Stan-Reifel/Nightlight-DFM-ENGR3260/README.md

# Nightlight-DFM-ENGR3260

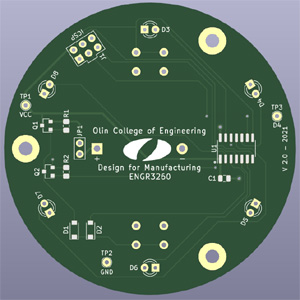
[picture p1: NightLightPCB-Top-ATTiny-300.jpg]
NightLightPCB-Top-ATTiny-300
