Stan-Reifel/Nightlight-DFM-ENGR3260/2021/Hardware/NightLight-BOM- Digikey.xls

Ref | Qnty | Value | Cmp name | Vendor
BT1, | 1 | CR2032_Holder | Battery_Cell | BS-7-ND or 36-1066-ND
D3, D4, D5, D6, D7, D8, | 6 | White LED | LED | 1516-QBL7IW60D-WW-ND
J1, | 1 | ISP Connector | ISP_Connector | S2012EC-03-ND
SW1, | 1 | POWER | SW_Push | EG1833-ND
SW2, | 1 | MODE | SW_Push | EG1833-ND
