Stan-Reifel/Nightlight-DFM-ENGR3260/2021/Hardware/Gerbers/NightLight-BOM.csv

Designator | Quantity | Value | Footprint | LCSC Part #
C1, | 1 | 100nf | 0805 | C49678
D1, D2, | 2 | 1N4148 | SOD-123 | C81598
Q1, | 1 | IRLML2244 | SOT-23 | C169763
Q2, | 1 | IRLML6344 | SOT-23 | C53550
R1, R2, | 2 | 680K | 0805 | C17797
U1, | 1 | ATtiny44A-SSU | SOIC-14 | C412819
