Stan-Reifel/Nightlight-DFM-ENGR3260/2020/LEDAlignmentJig/LEDAlignmentJig.SLDPRT

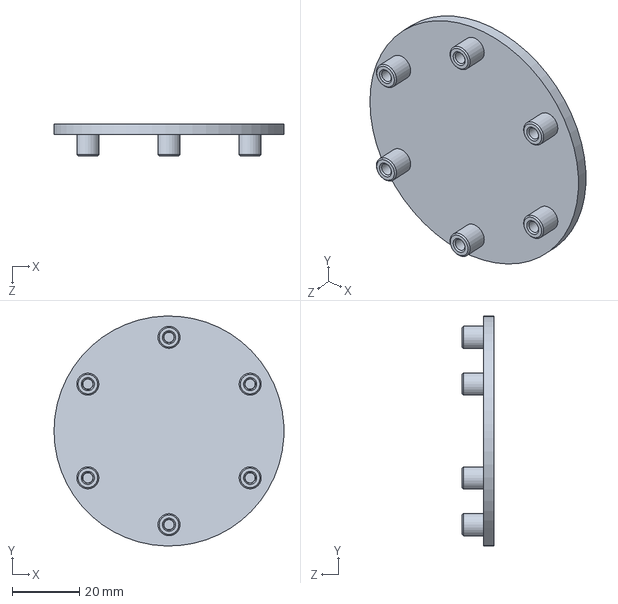
[picture p2: CAD file, 2020-09-29]
2020/LEDAlignmentJig/LEDAlignmentJig.SLDPRT
68.6 x 68.5 x 9.53 mm
