Stan-Reifel/Nightlight-DFM-ENGR3260/2020/SolidworksForPCBLayout/SolidworksForPCBLayout.SLDPRT

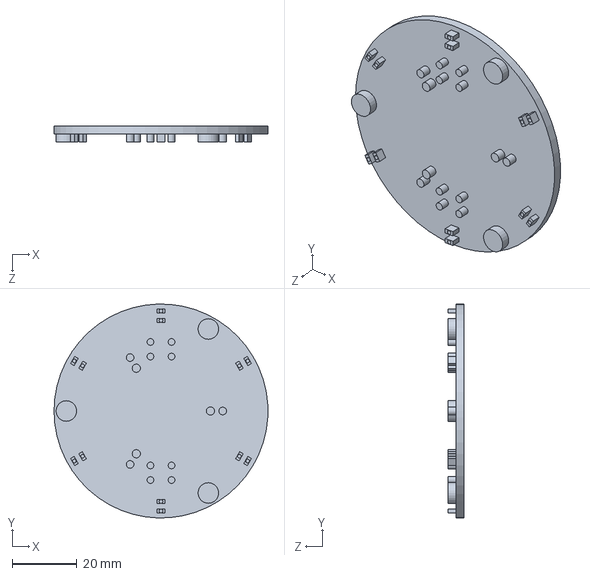
[picture p3: CAD file, 2021-07-24]
2020/SolidworksForPCBLayout/SolidworksForPCBLayout.SLDPRT
66.0 x 66.0 x 5.08 mm
