Stan-Reifel/Nightlight-DFM-ENGR3260/(list of files, cad)

Other CAD files:
2020/LEDAlignmentJig/LEDAlignmentJig.STL
2020/SolidworksForPCBLayout/SolidworksForPCBLayout.SLDDRW
