Stan-Reifel/Nightlight-DFM-ENGR3260/2021/Hardware/NightLight.kicad_pcb

## KiCad design 2021/Hardware/NightLight.kicad_pcb (2022-08-03)

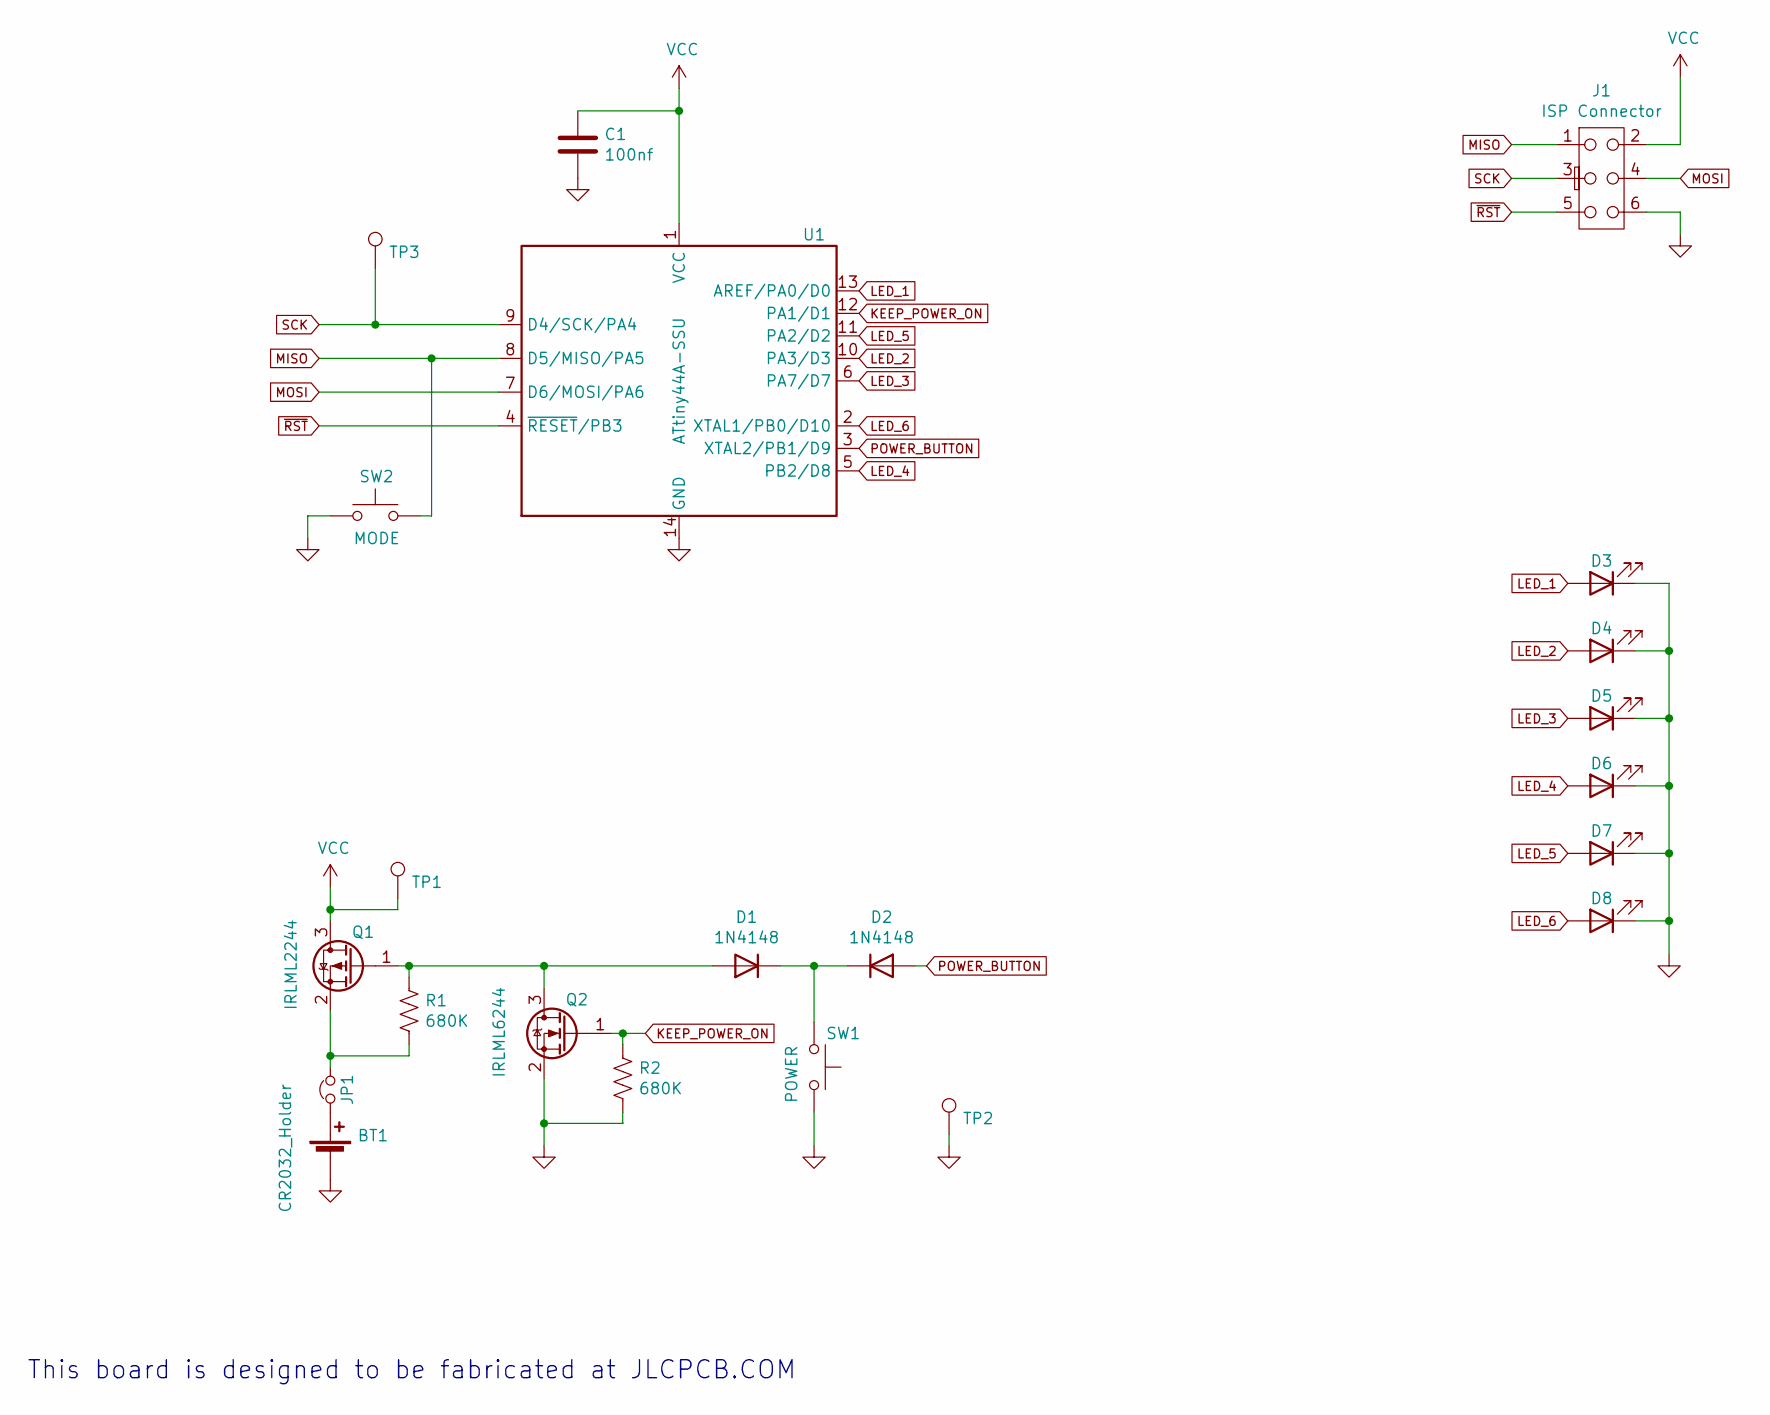
[picture p4: schematic NightLight.kicad_sch, Design for Manufacturing - Night Light]

Parts:
BT1: CR2032_Holder; BS_7_ND_for_CR2032
C1: 100nf; C_0805_2012Metric
D1, D2: 1N4148; D_SOD-123
D3, D4, D5, D6, D7, D8: White LED; LED_D3.0mm
J1: ISP Connector; ICSP
JP1: Jumper_NC_Small; Jumper-Closed
Q1: IRLML2244; SOT-23
Q2: IRLML6244; SOT-23
R1, R2: 680K; R_0805_2012Metric_Pad1.15x1.40mm_HandSolder
SW1: POWER; SW_PUSH_6mm
SW2: MODE; SW_PUSH_6mm
TP1: VCCTestPoint; TestPoint_THTPad_D2.0mm_Drill1.0mm
TP2: GndTestPoint; TestPoint_THTPad_D2.0mm_Drill1.0mm
TP3: D8TestPoint; TestPoint_THTPad_D2.0mm_Drill1.0mm
U1: ATtiny44A-SSU; SOIC-14_3.9x8.7mm_P1.27mm

Connections:
GND: BT1.2 (-), C1.2, D3.1 (K), D4.1 (K), D5.1 (K), D6.1 (K), D7.1 (K), D8.1 (K), J1.6, Q2.2 (S), R2.2, SW1.2, SW2.1, TP2.1, U1.14 (GND)
KEEP_POWER_ON: Q2.1 (G), R2.1, U1.12 (PA1/D1)
LED_1: D3.2 (A), U1.13 (AREF/PA0/D0)
LED_2: D4.2 (A), U1.10 (PA3/D3)
LED_3: D5.2 (A), U1.6 (PA7/D7)
LED_4: D6.2 (A), U1.5 (PB2/D8)
LED_5: D7.2 (A), U1.11 (PA2/D2)
LED_6: D8.2 (A), U1.2 (XTAL1/PB0/D10)
MISO: J1.1, SW2.2, U1.8 (D5/MISO/PA5)
MOSI: J1.4, U1.7 (D6/MOSI/PA6)
unnamed: BT1.1 (+), JP1.1
unnamed: D1.1 (K), D2.1 (K), SW1.1
unnamed: D1.2 (A), Q1.1 (G), Q2.3 (D), R1.1
unnamed: JP1.2, Q1.2 (S), R1.2
POWER_BUTTON: D2.2 (A), U1.3 (XTAL2/PB1/D9)
SCK: J1.3, TP3.1, U1.9 (D4/SCK/PA4)
VCC: C1.1, J1.2, Q1.3 (D), TP1.1, U1.1 (VCC)
~RST: J1.5, U1.4 (~RESET/PB3)

Notes on the sheet:
This board is designed to be fabricated at JLCPCB.COM

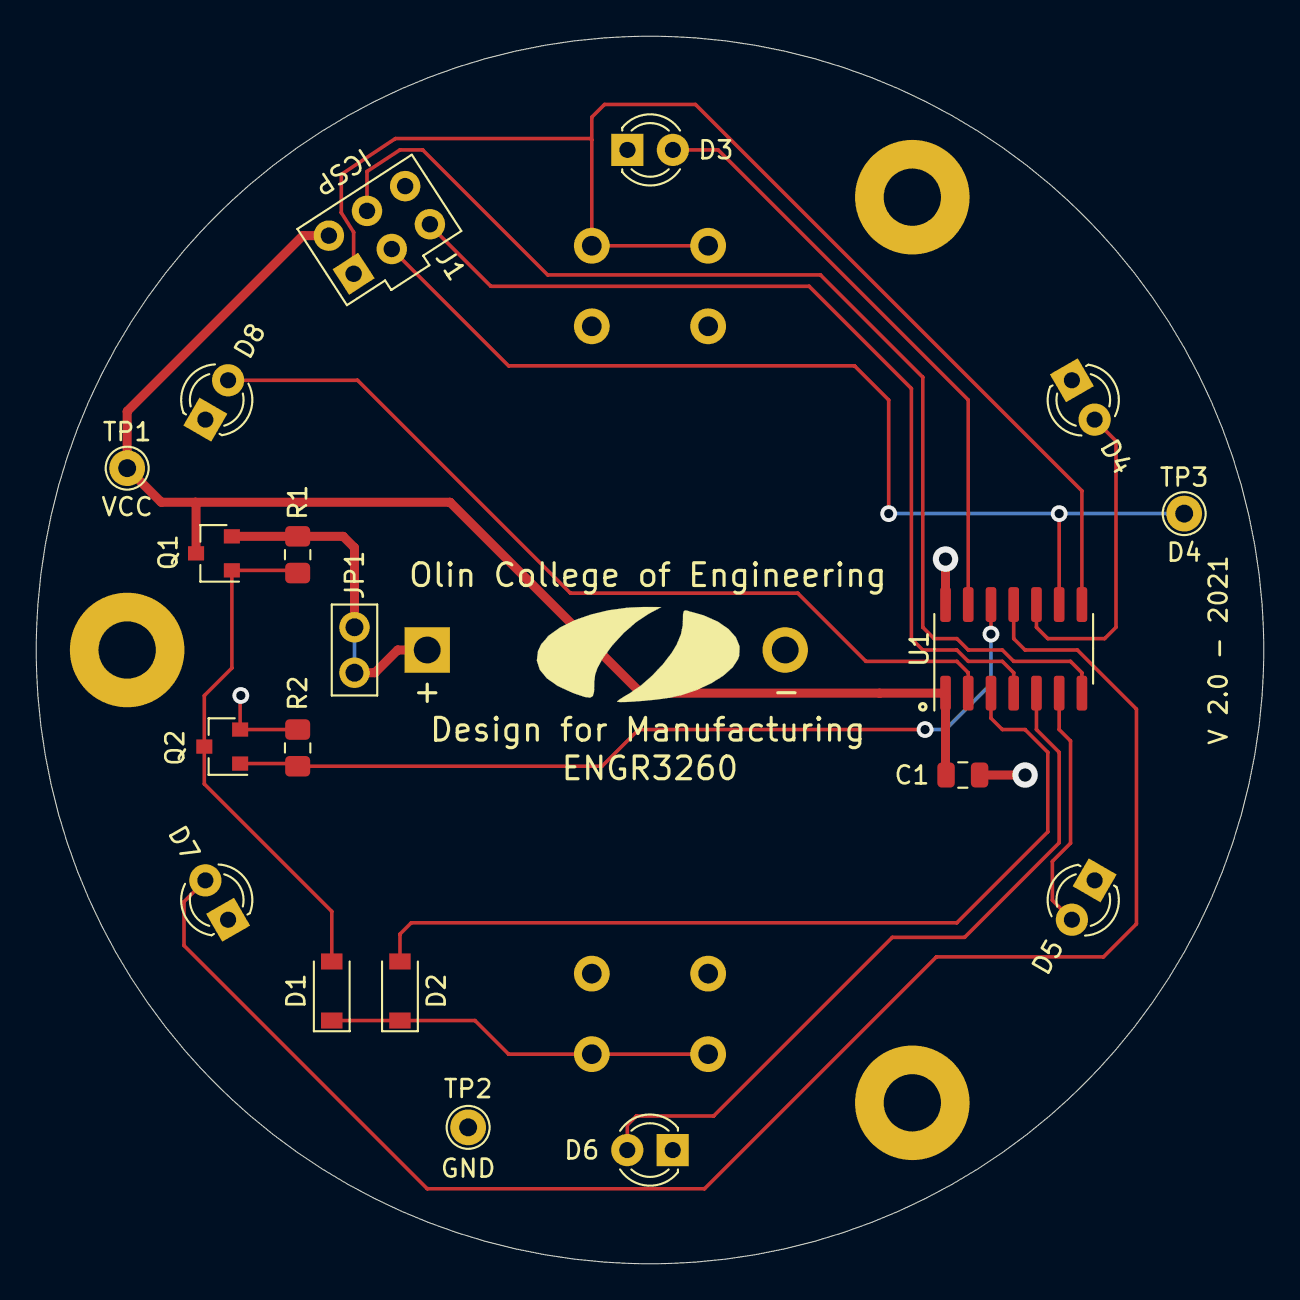
[picture p5: board NightLight.kicad_pcb from above]

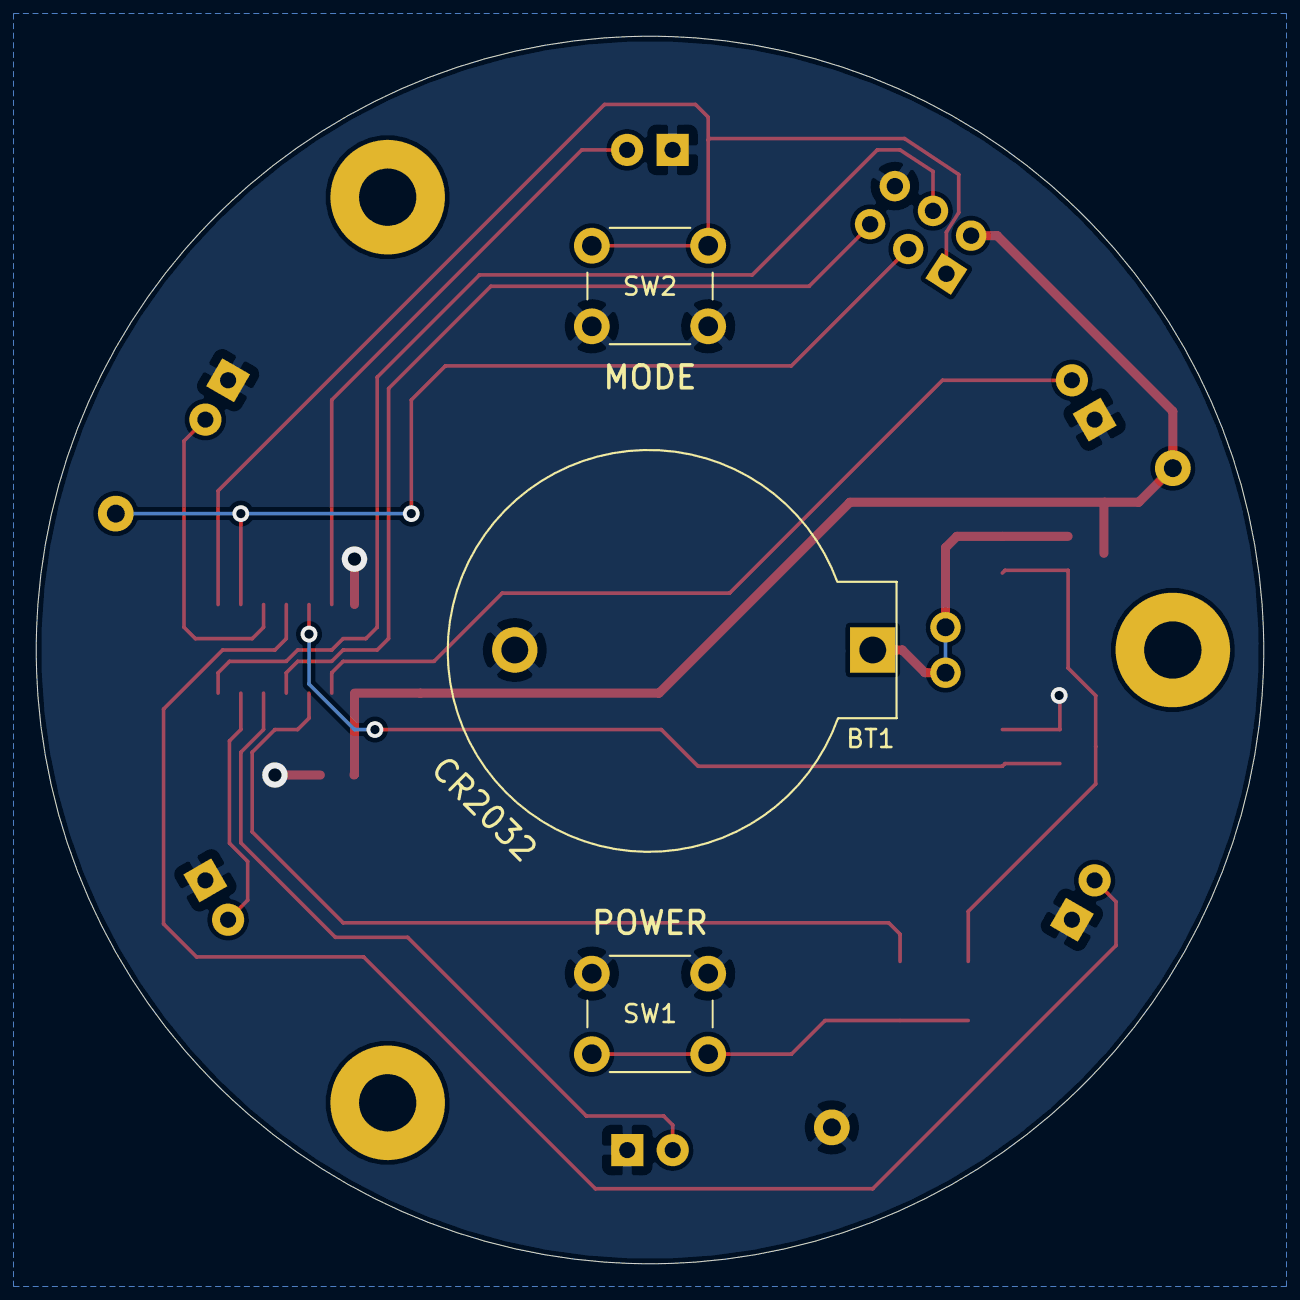
[picture p6: board NightLight.kicad_pcb from below]

Board: 2 copper layers, 68.6 x 68.6 mm, 22 parts (3 on the bottom side), 18 nets.
